Phalkon-Industries/phoenix-instrument/README.md

Git repo for the content of the new Phoenix ph handheld instrument.
