Phalkon-Industries/phoenix-instrument/kicad/phoenix-main-board/PCB Art/V1.0.0-Stormcloud.png

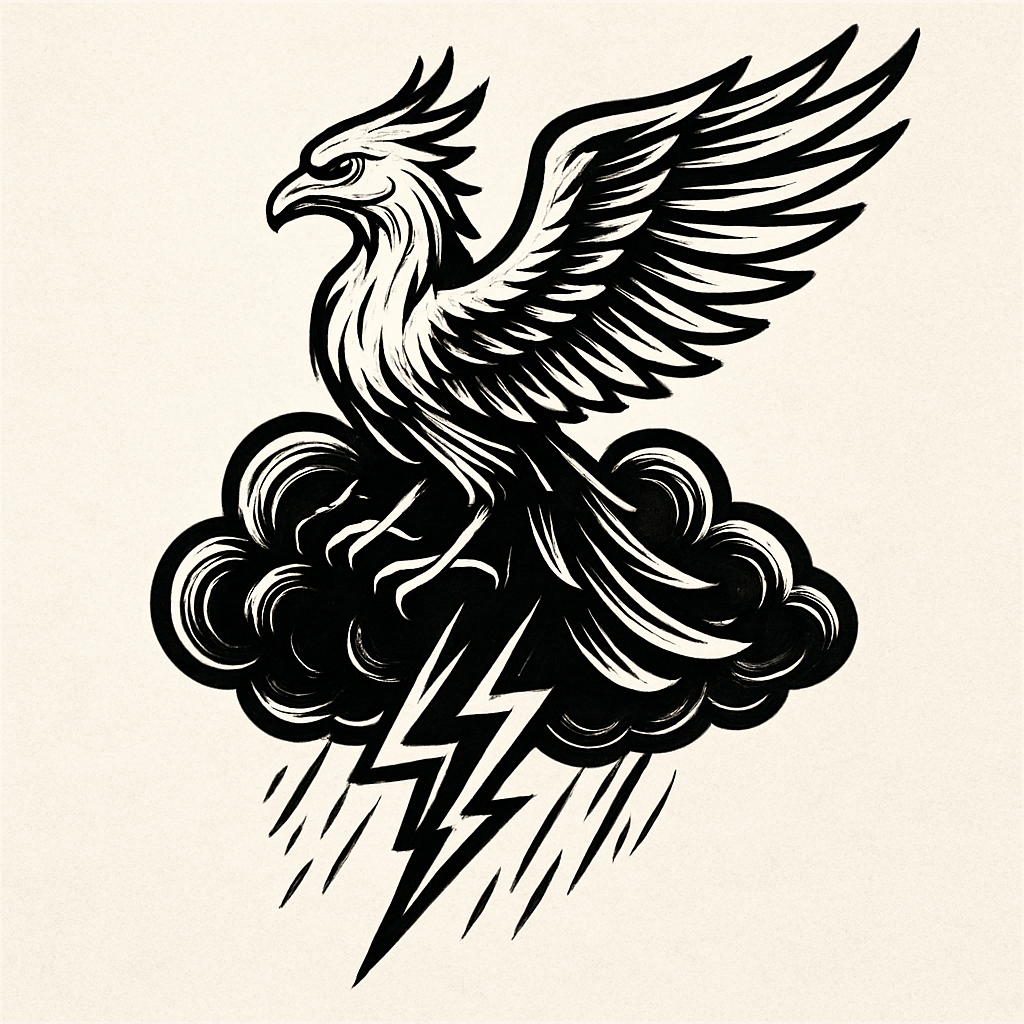
kicad/phoenix-main-board/PCB Art/V1.0.0-Stormcloud.png
