Phalkon-Industries/phoenix-instrument/kicad/phoenix-main-board/PCB Art/V1.0.1-Tsunami.png

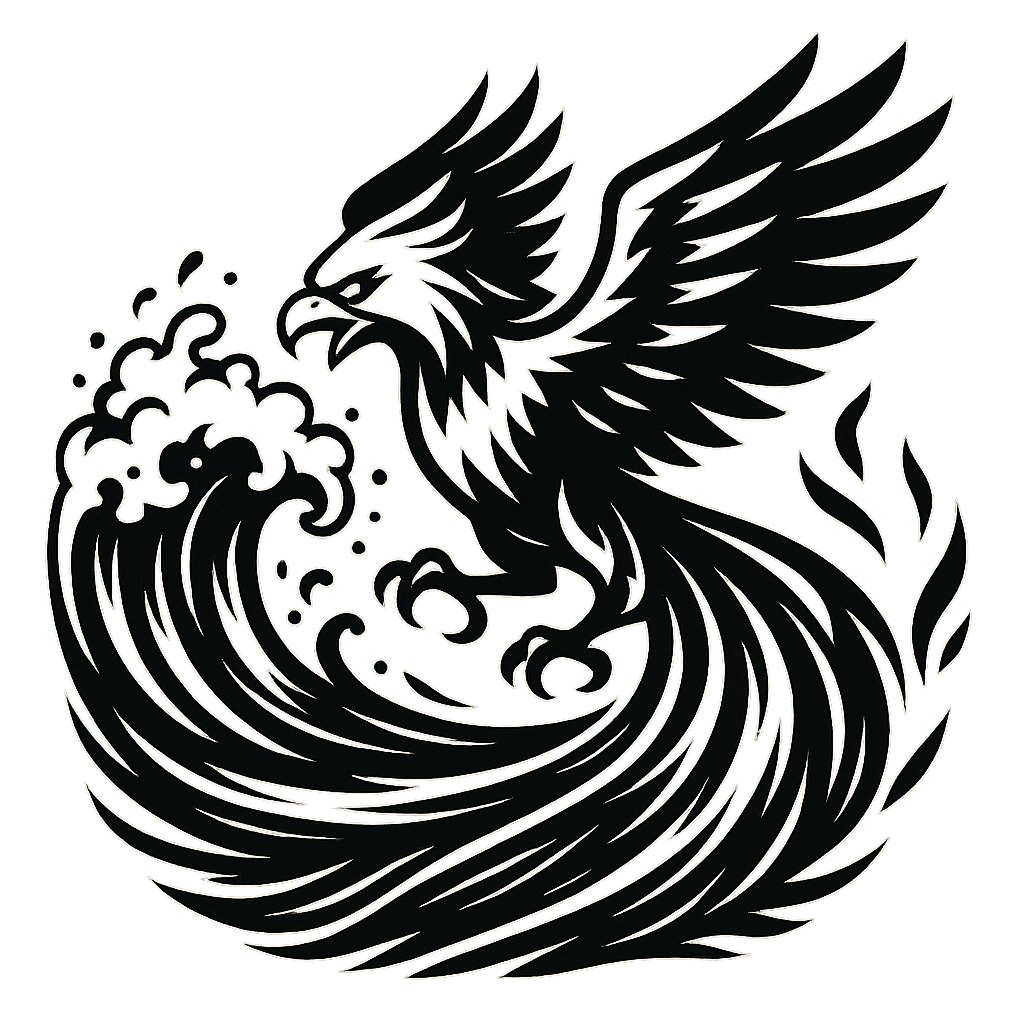
kicad/phoenix-main-board/PCB Art/V1.0.1-Tsunami.png
