Phalkon-Industries/phoenix-instrument/kicad/phoenix-main-board/PCB Art/V1.1.0-Tornado.png

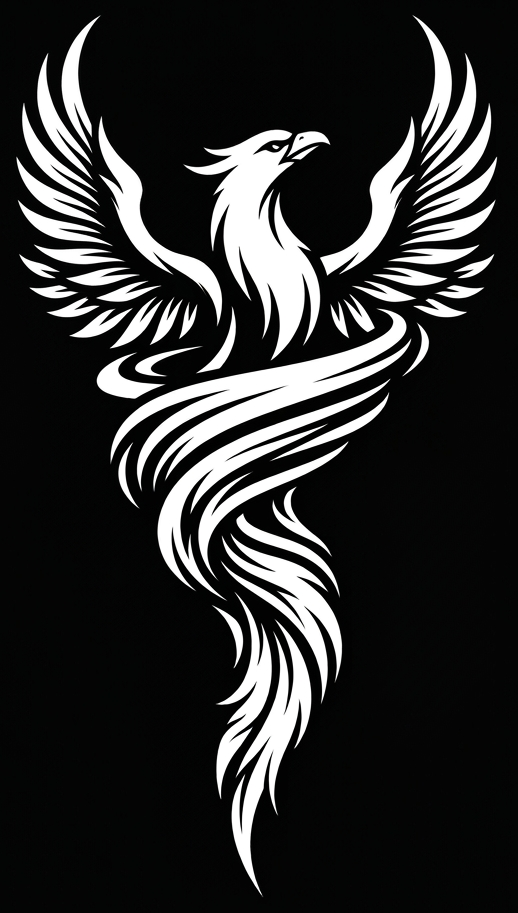
kicad/phoenix-main-board/PCB Art/V1.1.0-Tornado.png
