Phalkon-Industries/phoenix-instrument/kicad/phoenix-main-board/phoenix-main-board-BOM.csv

Id | Designator | Footprint | Quantity | Designation | Supplier and ref
1 | TP25,TP11,TP31,TP7,TP2,TP16,TP23,TP22,TP9,TP33,TP14,TP15,TP5,TP3,TP1,TP26,TP34,TP10,TP4,TP19,TP18,TP32,TP29,TP27,TP17,TP20,TP8,TP24,TP6,TP12,TP28,TP21,TP13 | TestPoint_Keystone_5000-5004_Miniature | 33 | TestPoint_Small
2 | U11 | Texas_RSA_VQFN-16-1EP_4x4mm_P0.65mm_EP2.7x2.7mm | 1 | MCP41U83T
3 | R19,R20 | R_0603_1608Metric | 2 | 100
4 | R7,R8,R10,R11,R12,Rout1,R13,R16,R9 | R_0603_1608Metric | 9 | 10
5 | C12,C18,C7,C13,C16,C15,C21,C1,C17,C4 | C_0603_1608Metric | 10 | 100nF
6 | C5,C2 | C_0603_1608Metric | 2 | 4.7uF
7 | U1 | VSSOP-8_3x3mm_P0.65mm | 1 | LM7705
8 | U7 | MSOP-8_3x3mm_P0.65mm | 1 | OPA2380
9 | C6,C14,C8,C3 | C_0603_1608Metric | 4 | 10uF
10 | FID3,FID2 |  | 2
11 | R2,RFB2,RFB1 | R_0603_1608Metric | 3 | 0
12 | Rset1 | R_0603_1608Metric | 1 | 20k
13 | U2 | DFN-8-1EP_3x3mm_P0.5mm_EP1.66x2.38mm | 1 | LT3092xDD
14 | R5,R4 | R_0603_1608Metric | 2 | 2K
15 | C9 | C_0603_1608Metric | 1 | 22uF
16 | C11,C20,C10,C19 | C_0603_1608Metric | 4 | 1uF
17 | U5 | VSSOP-8_2.3x2mm_P0.5mm | 1 | TS5A3359
18 | R3 | R_0603_1608Metric | 1 | 75
19 | U9 | TSSOP-20_4.4x6.5mm_P0.65mm | 1 | MCP3564
20 | TH1 | R_0603_1608Metric | 1 | DriveStageThermistor
21 | R14,R24,R18,R23,R21,R17,R15,R6 | R_0603_1608Metric | 8 | 10k
22 | U3 | SOT-23-6 | 1 | MCP1640Bx-xCHY
23 | L1 | L_Wuerth_WE-TPC-3816 | 1 | 4.7uH
24 | R26 | R_0603_1608Metric | 1 | 301k
25 | FID1 | Fiducial_1mm_Mask2mm | 1 | Fiducial_1mm_Mask2mm
26 | U12 | SOT-23-5 | 1 | TPS7A2050
27 | TH5 | R_0603_1608Metric | 1 | GainStageThermistor
28 | U8 | TSSOP-16_4.4x5mm_P0.65mm | 1 | AD5242
29 | R1 | R_0603_1608Metric | 1 | 182
30 | U6 | SOT-23-5 | 1 | TPS7A2033
31 | R25 | R_0603_1608Metric | 1 | 1M
32 | FB1 | R_0603_1608Metric | 1 | 120ohm@100MHz
33 | TH4 | ThermistorWire | 1 | BlueLED Thermistor
34 | D2 | LED_D5.0mm_Horizontal_O1.27mm_Z3.0mm | 1 | GreenLED
35 | D1 | LED_D5.0mm_Horizontal_O1.27mm_Z3.0mm | 1 | BlueLED
36 | TH2 | ThermistorWire | 1 | Sample Thermistor
37 | U4 | Adafruit Feather nrf52840 Express | 1 | Adafruit_Feather_nrf52840_Express
38 | PD_Green1,PD_Blue1 | PD_Vertical | 2 | Photodiode
39 | TH3 | ThermistorWire | 1 | GreenLEDThermistor
