Phalkon-Industries/phoenix-instrument/freecad/phoenix-assembly.FCStd

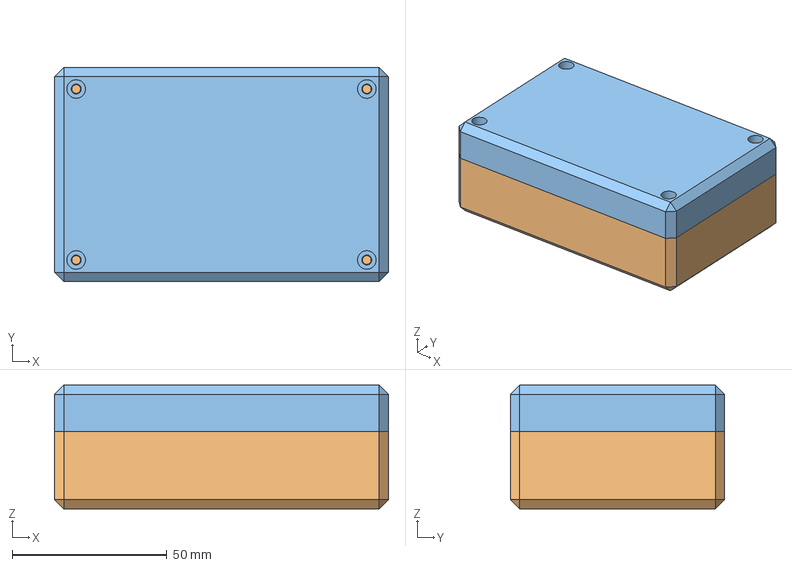
[picture p4: CAD file, 2026-10-06]
freecad/phoenix-assembly.FCStd
107.9 x 69.2 x 40.0 mm
