Phalkon-Industries/phoenix-instrument/freecad/lee-filter-holder-for-cuvette.FCStd

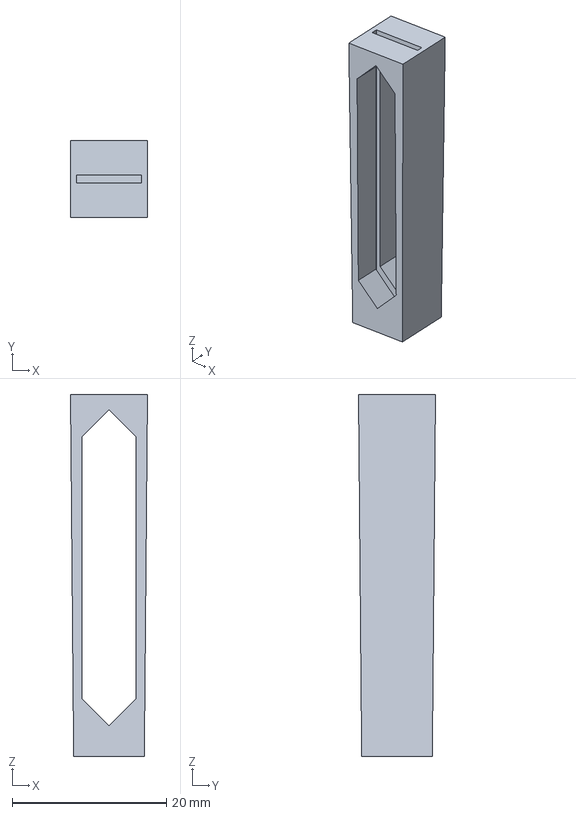
[picture p5: CAD file, 2026-03-20]
freecad/lee-filter-holder-for-cuvette.FCStd
10.0 x 10.0 x 47.0 mm
