Phalkon-Industries/phoenix-instrument/freecad/prusaslicer-enclosure.3mf

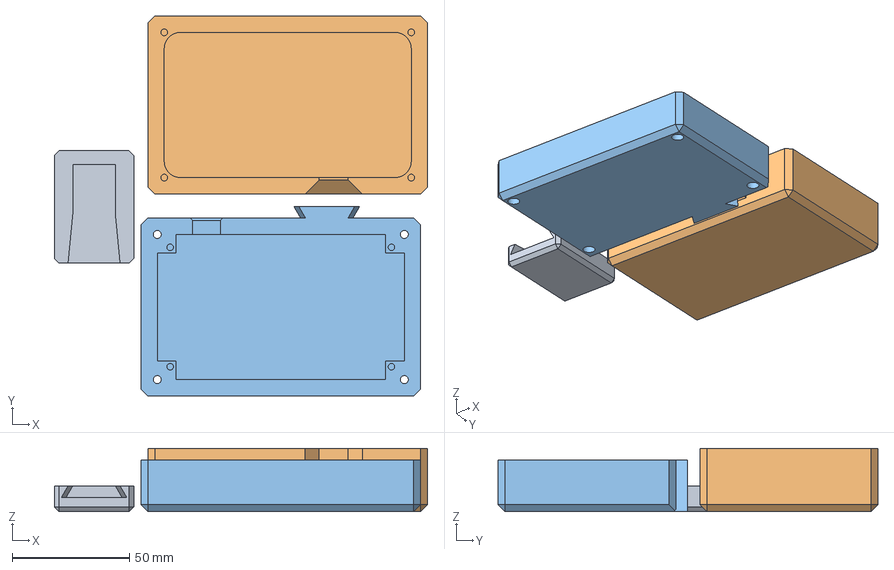
[picture p6: CAD file, 2026-03-20]
freecad/prusaslicer-enclosure.3mf
159.4 x 162.3 x 27.0 mm
ecnlosure-cap
ecnlosure-front
ecnlosure-back
