Phalkon-Industries/phoenix-instrument/freecad/ecnlosure-cap.3mf

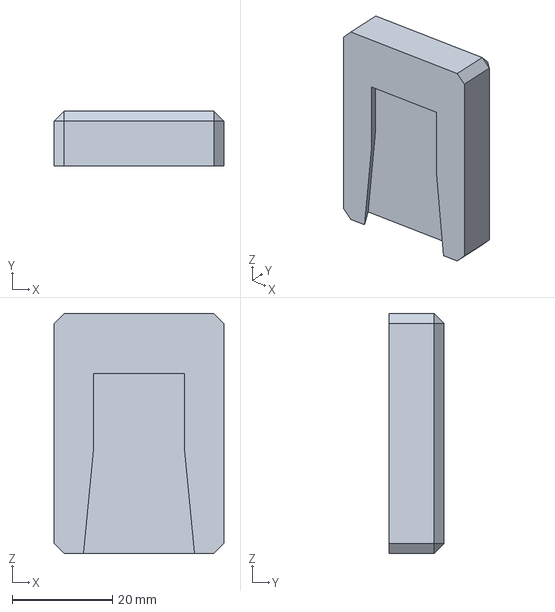
[picture p7: CAD file, 2025-12-11]
freecad/ecnlosure-cap.3mf
33.9 x 11.0 x 48.0 mm
