Phalkon-Industries/phoenix-instrument/freecad/ecnlosure-front.3mf

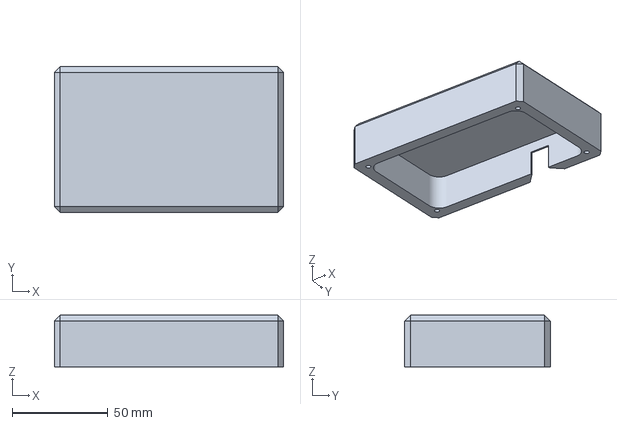
[picture p8: CAD file, 2025-12-11]
freecad/ecnlosure-front.3mf
119.5 x 76.0 x 27.0 mm
