Phalkon-Industries/phoenix-instrument/freecad/ecnlosure-back.3mf

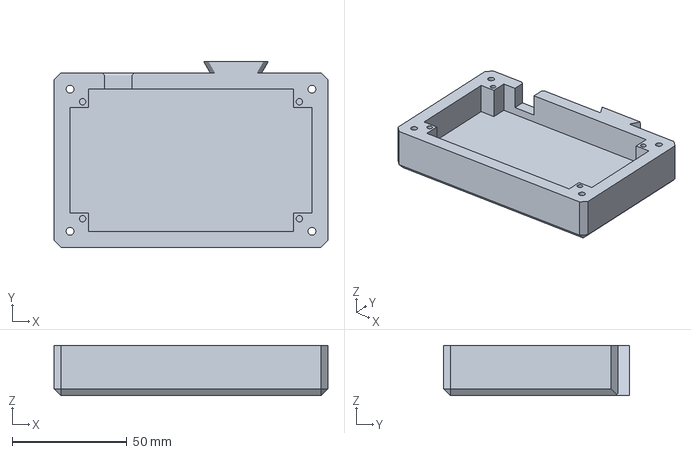
[picture p9: CAD file, 2025-12-11]
freecad/ecnlosure-back.3mf
119.5 x 81.0 x 22.0 mm
