Phalkon-Industries/phoenix-instrument/freecad/shroud-test.3mf

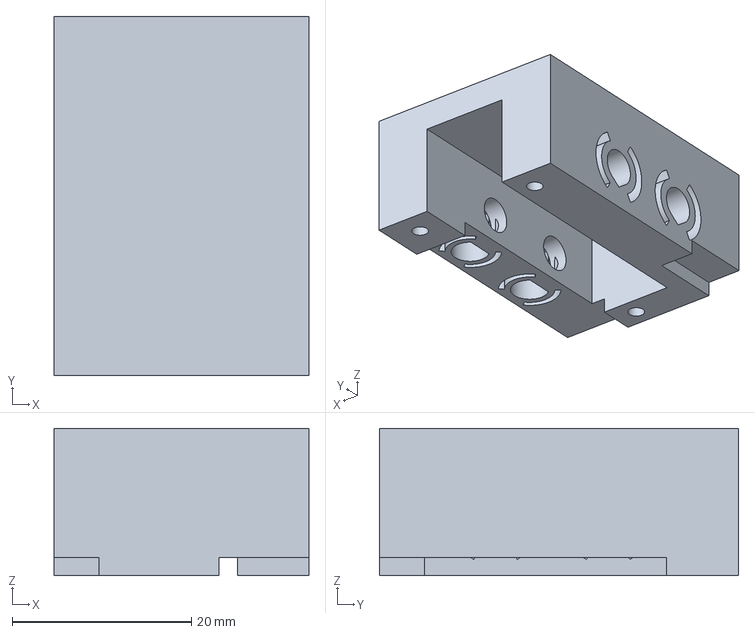
[picture p10: CAD file, 2025-12-05]
freecad/shroud-test.3mf
28.4 x 40.0 x 16.4 mm
