Phalkon-Industries/phoenix-instrument/freecad/Cuvette.FCStd

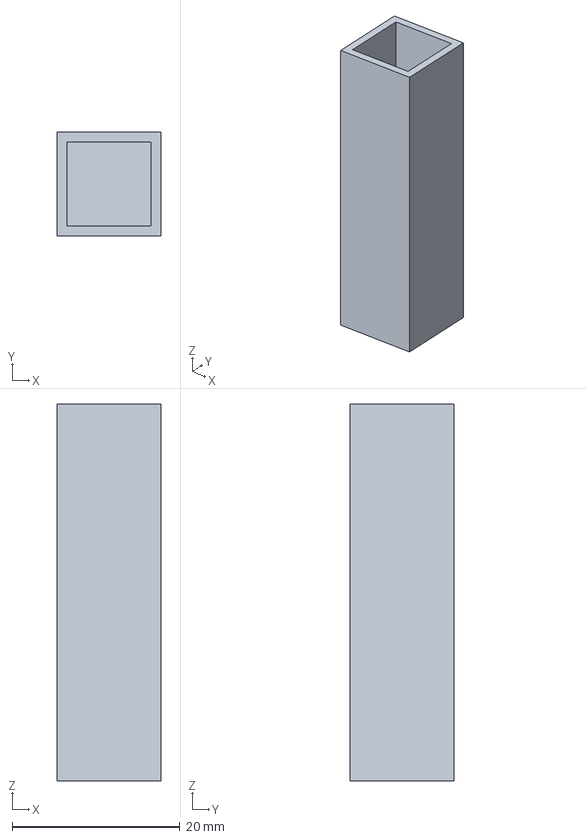
[picture p11: CAD file, 2025-12-05]
freecad/Cuvette.FCStd
12.4 x 12.4 x 45.0 mm
