Phalkon-Industries/phoenix-instrument/freecad/Photodiode.FCStd

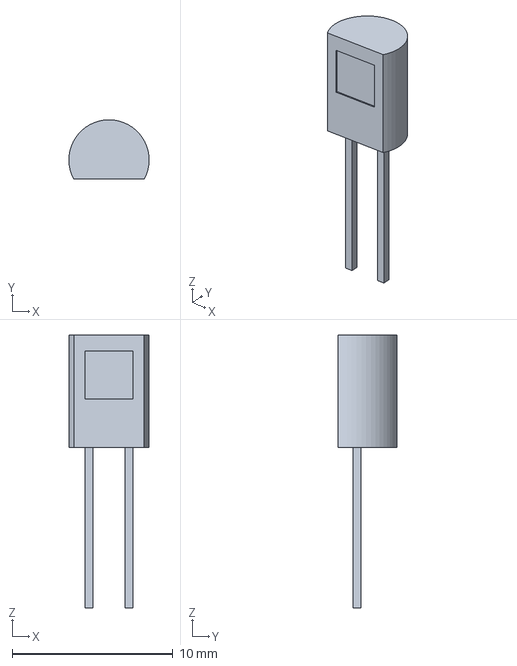
[picture p12: CAD file, 2025-12-05]
freecad/Photodiode.FCStd
5.00 x 3.70 x 17.0 mm
