Phalkon-Industries/phoenix-instrument/freecad/LED.FCStd

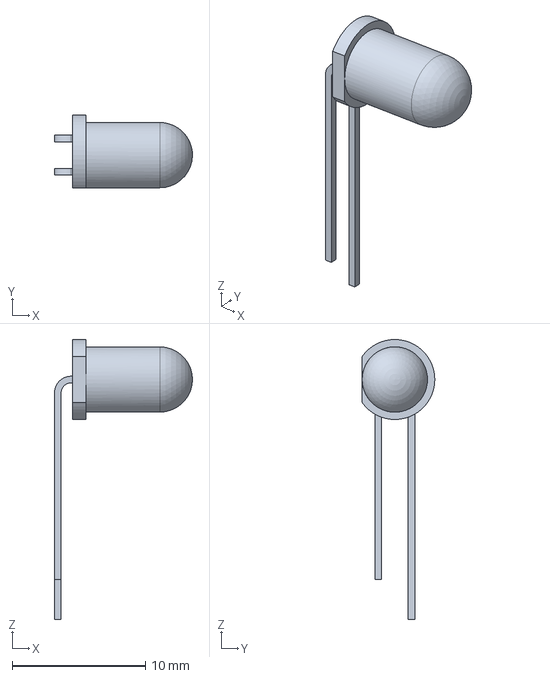
[picture p13: CAD file, 2025-12-05]
freecad/LED.FCStd
10.4 x 5.45 x 21.0 mm
