Phalkon-Industries/phoenix-instrument/freecad/phoenix-pcb-v1.0.1-tsunami.FCStd

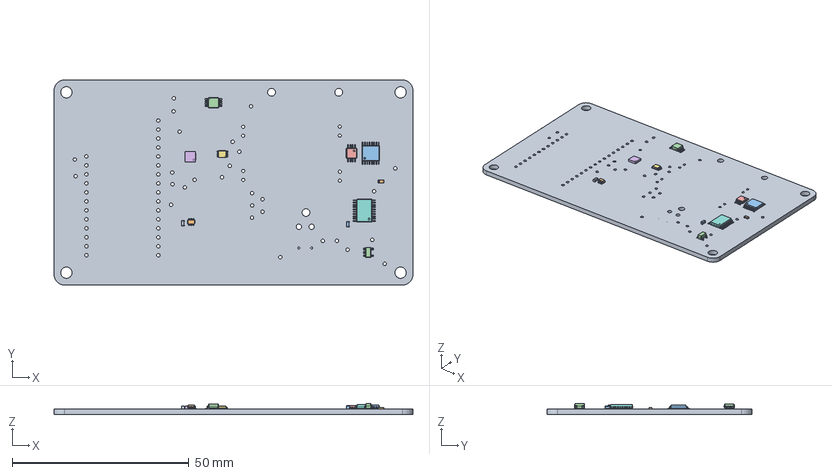
[picture p14: CAD file, 2025-12-05]
freecad/phoenix-pcb-v1.0.1-tsunami.FCStd
101.5 x 58.0 x 3.15 mm
Pcb_bfa0
R19_R_0603_1608Metric_e81c35781ce5
C12_C_0603_1608Metric_43dd25189e75
U1_VSSOP-8_3x3mm_P0.65mm_b0bd8732d9d8
U7_MSOP_8_3x3mm_P065mm_0b8d5e192aae
U2_DFN-8-1EP_3x3mm_Pitch0.5mm_9c5140f70b24
U5_VSSOP_8_23x2mm_P05mm_af9a6c2f9d9d
U9_TSSOP_20_44x65mm_P065mm_1748040f196b
L1_L_0603_1608Metric_6e4b57586c89
U3_SOT_363_SC_70_6_2b77724525eb
U8_TSSOP_16_44x5mm_P065mm_5ce80917f075
U6_SOT_23_5_cae0d91c1014
