Phalkon-Industries/phoenix-instrument/(list of files, cad)

Other CAD files:
freecad/lee-filter-holder-for-cuvette-BodyPocket002.step
