Phalkon-Industries/phoenix-instrument/kicad/phoenix-main-board/phoenix-main-board.kicad_pcb

## KiCad design kicad/phoenix-main-board/phoenix-main-board.kicad_pcb (2026-10-06)

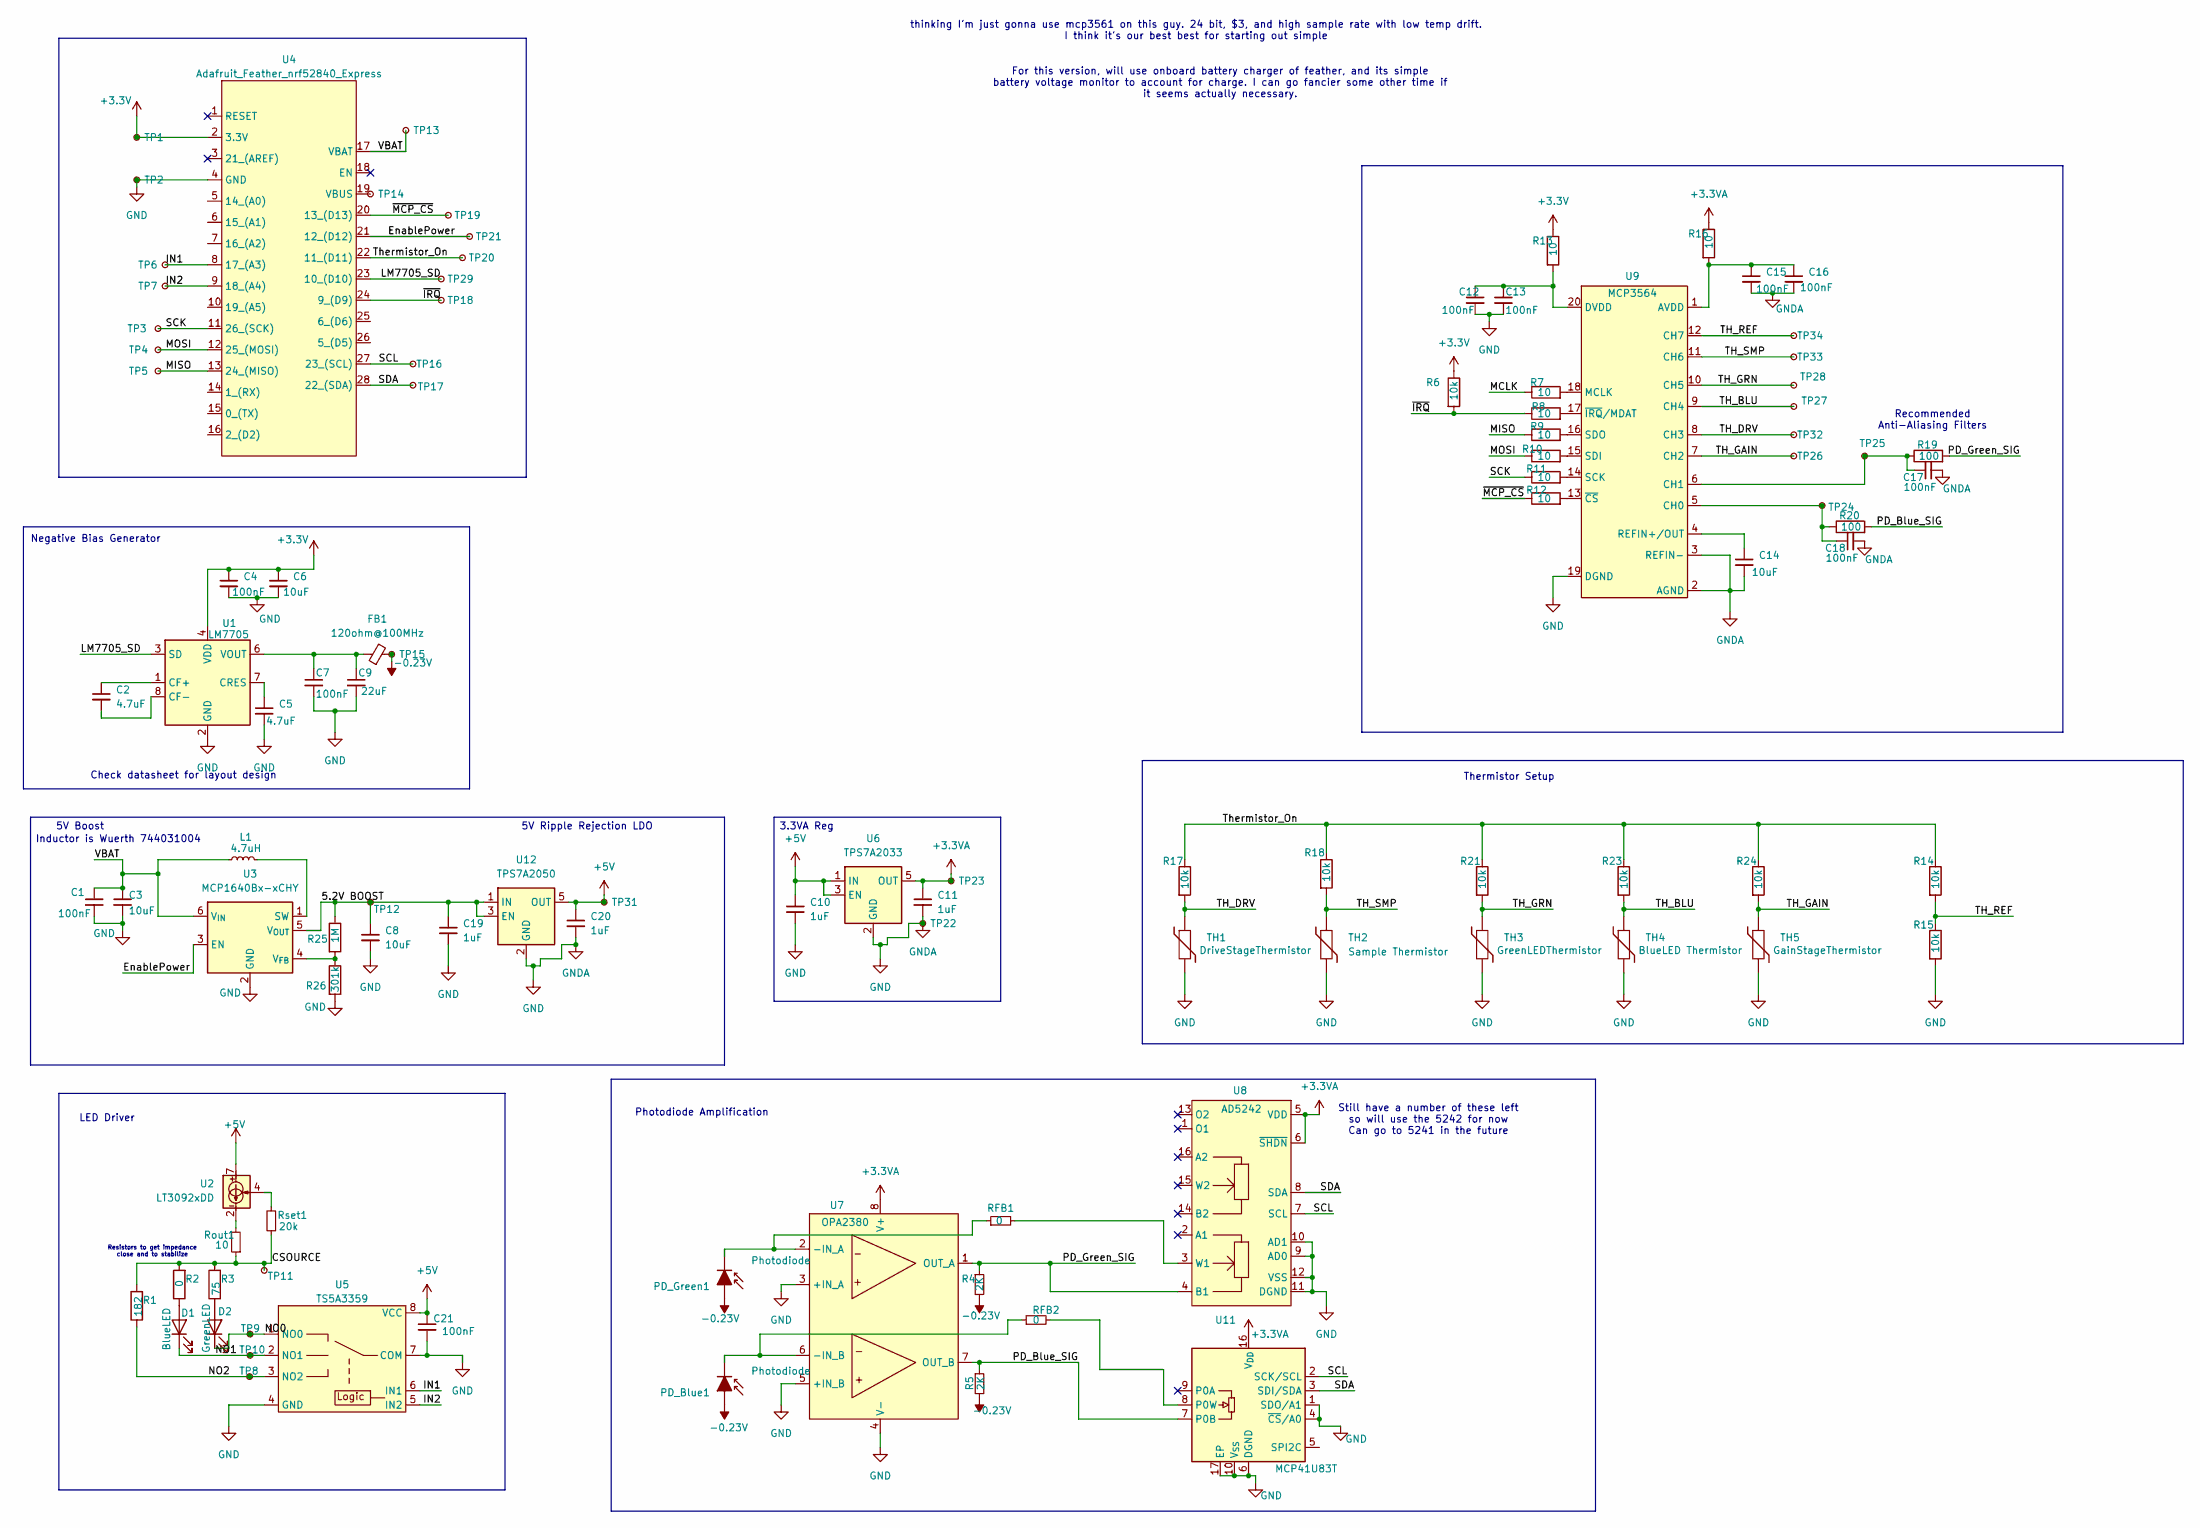
[picture p15: schematic phoenix-main-board.kicad_sch]

Parts:
C1, C4, C7, C12, C13, C15, C16, C17, C18, C21: 100nF; C_0603_1608Metric
C2, C5: 4.7uF; C_0603_1608Metric
C3, C6, C8, C14: 10uF; C_0603_1608Metric
C9: 22uF; C_0603_1608Metric
C10, C11, C19, C20: 1uF; C_0603_1608Metric
D1: BlueLED; LED_D5.0mm_Horizontal_O1.27mm_Z3.0mm
D2: GreenLED; LED_D5.0mm_Horizontal_O1.27mm_Z3.0mm
FB1: 120ohm@100MHz; R_0603_1608Metric
L1: 4.7uH; L_Wuerth_WE-TPC-3816
PD_Blue1: Photodiode; PD_Vertical
PD_Green1: Photodiode; PD_Vertical
R1: 182; R_0603_1608Metric
R2: 0; R_0603_1608Metric
R3: 75; R_0603_1608Metric
R4, R5: 2K; R_0603_1608Metric
R6, R14, R15, R17, R18, R21, R23, R24: 10k; R_0603_1608Metric
R7, R8, R9, R10, R11, R12, R13, R16: 10; R_0603_1608Metric
R19, R20: 100; R_0603_1608Metric
R25: 1M; R_0603_1608Metric
R26: 301k; R_0603_1608Metric
RFB1, RFB2: 0; R_0603_1608Metric
Rout1: 10; R_0603_1608Metric
Rset1: 20k; R_0603_1608Metric
TH1: DriveStageThermistor; R_0603_1608Metric
TH2: Sample Thermistor; ThermistorWire
TH3: GreenLEDThermistor; ThermistorWire
TH4: BlueLED Thermistor; ThermistorWire
TH5: GainStageThermistor; R_0603_1608Metric
TP1, TP2, TP3, TP4, TP5, TP6, TP7, TP8, TP9, TP10, TP11, TP12, TP13, TP14, TP15, TP16, TP17, TP18, TP19, TP20, TP21, TP22, TP23, TP24, TP25, TP26, TP27, TP28, TP29, TP31, TP32, TP33, TP34: TestPoint_Small; TestPoint_Keystone_5000-5004_Miniature
U1: LM7705; VSSOP-8_3x3mm_P0.65mm
U2: LT3092xDD; DFN-8-1EP_3x3mm_P0.5mm_EP1.66x2.38mm
U3: MCP1640Bx-xCHY; SOT-23-6
U4: Adafruit_Feather_nrf52840_Express; Adafruit Feather nrf52840 Express
U5: TS5A3359; VSSOP-8_2.3x2mm_P0.5mm
U6: TPS7A2033; SOT-23-5
U7: OPA2380; MSOP-8_3x3mm_P0.65mm
U8: AD5242; TSSOP-16_4.4x5mm_P0.65mm
U9: MCP3564; TSSOP-20_4.4x6.5mm_P0.65mm
U11: MCP41U83T; Texas_RSA_VQFN-16-1EP_4x4mm_P0.65mm_EP2.7x2.7mm
U12: TPS7A2050; SOT-23-5

Connections:
+3.3V: C4.1, C6.1, R6.1, R13.1, TP1.1, U1.4 (VDD), U4.2 (3.3V)
+3.3VA: C11.1, R16.1, TP23.1, U6.5 (OUT), U7.8 (V+), U8.5 (VDD), U8.6 (~SHDN), U11.16 (V_{DD})
+5V: C10.1, C20.1, C21.1, TP31.1, U2.7, U2.8, U5.8 (VCC), U6.1 (IN), U6.3 (EN), U12.5 (OUT)
-0.23V: FB1.2, PD_Blue1.2 (A), PD_Green1.2 (A), R4.2, R5.2, TP15.1
/5.2V BOOST: C8.1, C19.1, R25.1, TP12.1, U3.5 (V_{OUT}), U12.1 (IN), U12.3 (EN)
/CSOURCE: R1.2, R2.2, R3.2, Rout1.1, Rset1.1, TP11.1
/EnablePower: TP21.1, U3.3 (EN), U4.21 (12_(D12))
/IN1: TP6.1, U4.8 (17_(A3)), U5.6 (IN1)
/IN2: TP7.1, U4.9 (18_(A4)), U5.5 (IN2)
/LM7705_SD: TP29.1, U1.3 (SD), U4.23 (10_(D10))
/MCLK: R7.1
/MISO: R9.1, TP5.1, U4.13 (24_(MISO))
/MOSI: R10.1, TP4.1, U4.12 (25_(MOSI))
/NO0: D2.1 (K), TP9.1, U5.1 (NO0)
/NO1: D1.1 (K), TP10.1, U5.2 (NO1)
/NO2: R1.1, TP8.1, U5.3 (NO2)
/PD_Blue_SIG: R5.1, R20.2, U7.7 (OUT_B), U11.7 (P0B)
/PD_Green_SIG: R4.1, R19.2, U7.1 (OUT_A), U8.4 (B1)
/SCK: R11.1, TP3.1, U4.11 (26_(SCK))
/SCL: TP16.1, U4.27 (23_(SCL)), U8.7 (SCL), U11.2 (SCK/SCL)
/SDA: TP17.1, U4.28 (22_(SDA)), U8.8 (SDA), U11.3 (SDI/SDA)
/TH_BLU: R23.2, TH4.1, TP27.1, U9.9 (CH4)
/TH_DRV: R17.2, TH1.1, TP32.1, U9.8 (CH3)
/TH_GAIN: R24.2, TH5.1, TP26.1, U9.7 (CH2)
/TH_GRN: R21.2, TH3.1, TP28.1, U9.10 (CH5)
/TH_REF: R14.2, R15.1, TP34.1, U9.12 (CH7)
/TH_SMP: R18.2, TH2.1, TP33.1, U9.11 (CH6)
/Thermistor_On: R14.1, R17.1, R18.1, R21.1, R23.1, R24.1, TP20.1, U4.22 (11_(D11))
/VBAT: C1.1, C3.1, L1.1, TP13.1, U3.6 (V_{IN}), U4.17 (VBAT)
/~IRQ: R6.2, R8.1, TP18.1, U4.24 (9_(D9))
/~MCP_CS: R12.1, TP19.1, U4.20 (13_(D13))
GND: C1.2, C3.2, C4.2, C5.2, C6.2, C7.2, C8.2, C9.2, C10.2, C11.2, C12.2, C13.2, C14.2, C15.2, C16.2, C17.2, C18.2, C19.2, C20.2, C21.2, R15.2, R26.2, TH1.2, TH2.2, TH3.2, TH4.2, TH5.2, TP2.1, TP22.1, U1.2 (GND), U1.5 (GND), U3.2 (GND), U4.4 (GND), U5.4 (GND), U5.7 (COM), U6.2 (GND), U7.3 (+IN_A), U7.4 (V-), U7.5 (+IN_B), U8.9 (AD0), U8.10 (AD1), U8.11 (DGND), U8.12 (VSS), U9.2 (AGND), U9.3 (REFIN-), U9.19 (DGND), U11.1 (SDO/A1), U11.4 (~CS/A0), U11.6 (DGND), U11.10 (V_{SS}), U11.17 (EP), U12.2 (GND)
unnamed: D1.2 (A), R2.1
unnamed: D2.2 (A), R3.1
unnamed: PD_Blue1.1 (K), RFB2.1, U7.6 (-IN_B)
unnamed: PD_Green1.1 (K), RFB1.1, U7.2 (-IN_A)
unnamed: Rout1.2, U2.1, U2.2, U2.9
unnamed: Rset1.2, U2.4
unnamed: C2.1, U1.1 (CF+)
unnamed: C2.2, U1.8 (CF-)
unnamed: C5.1, U1.7 (CRES)
unnamed: C7.1, C9.1, FB1.1, U1.6 (VOUT)
unnamed: L1.2, U3.1 (SW)
unnamed: R25.2, R26.1, U3.4 (V_{FB})
unnamed: TP14.1, U4.19 (VBUS)
unnamed: RFB1.2, U8.3 (W1)
unnamed: C15.1, C16.1, R16.2, U9.1 (AVDD)
unnamed: C18.1, R20.1, TP24.1, U9.5 (CH0)
unnamed: C17.1, R19.1, TP25.1, U9.6 (CH1)
unnamed: C12.1, C13.1, R13.2, U9.20 (DVDD)
unnamed: R7.2, U9.18 (MCLK)
unnamed: C14.1, U9.4 (REFIN+/OUT)
unnamed: R11.2, U9.14 (SCK)
unnamed: R10.2, U9.15 (SDI)
unnamed: R9.2, U9.16 (SDO)
unnamed: R12.2, U9.13 (~CS)
unnamed: R8.2, U9.17 (~IRQ/MDAT)
unnamed: RFB2.2, U11.8 (P0W)

Notes on the sheet:
Inductor is Wuerth 744031004
For this version, will use onboard battery charger of feather, and its simple battery voltage monitor to account for charge. I can go fancier some other time if it seems actually necessary.
Check datasheet for layout design
Photodiode Amplification
3.3VA Reg
Resistors to get impedance close and to stabilize
Recommended Anti-Aliasing Filters
thinking I'm just gonna use mcp3561 on this guy. 24 bit, $3, and high sample rate with low temp drift. I think it's our best best for starting out simple
LED Driver
5V Boost
Negative Bias Generator
Thermistor Setup
5V Ripple Rejection LDO
Still have a number of these left so will use the 5242 for now Can go to 5241 in the future

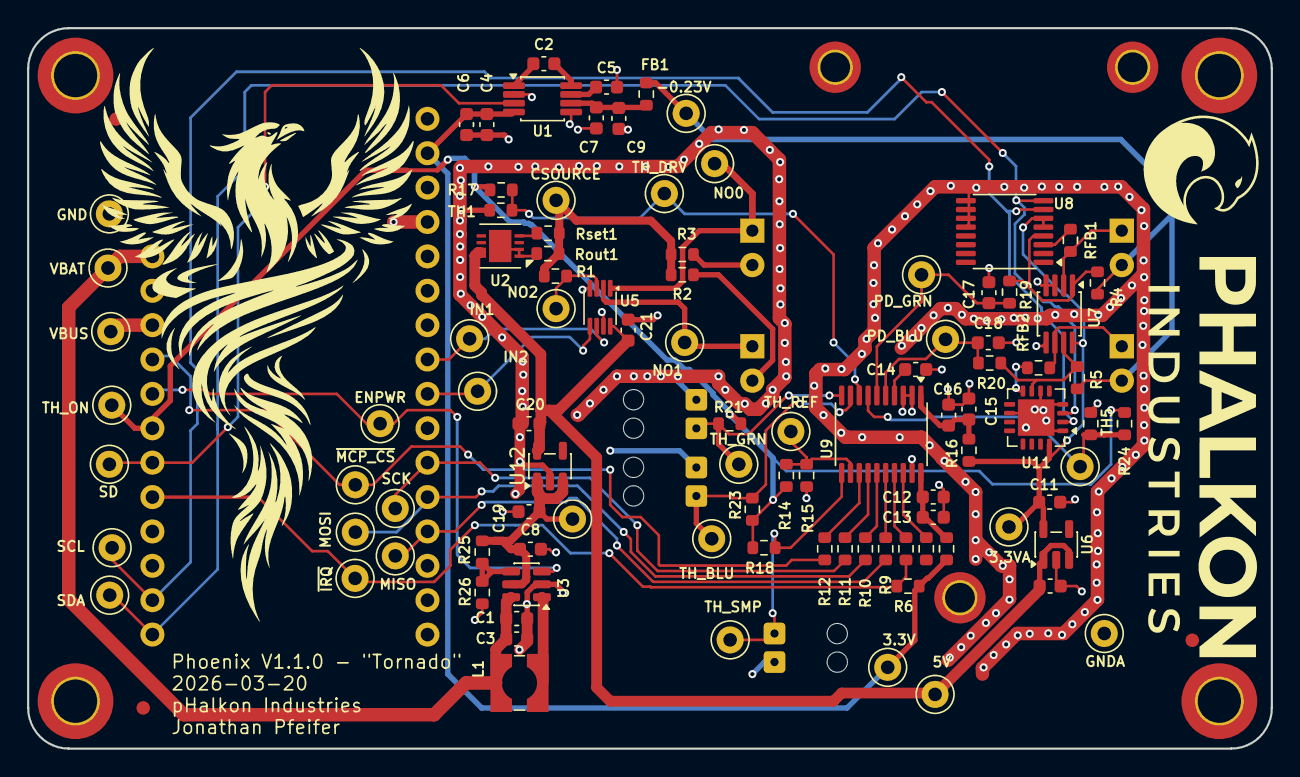
[picture p16: board phoenix-main-board.kicad_pcb from above]

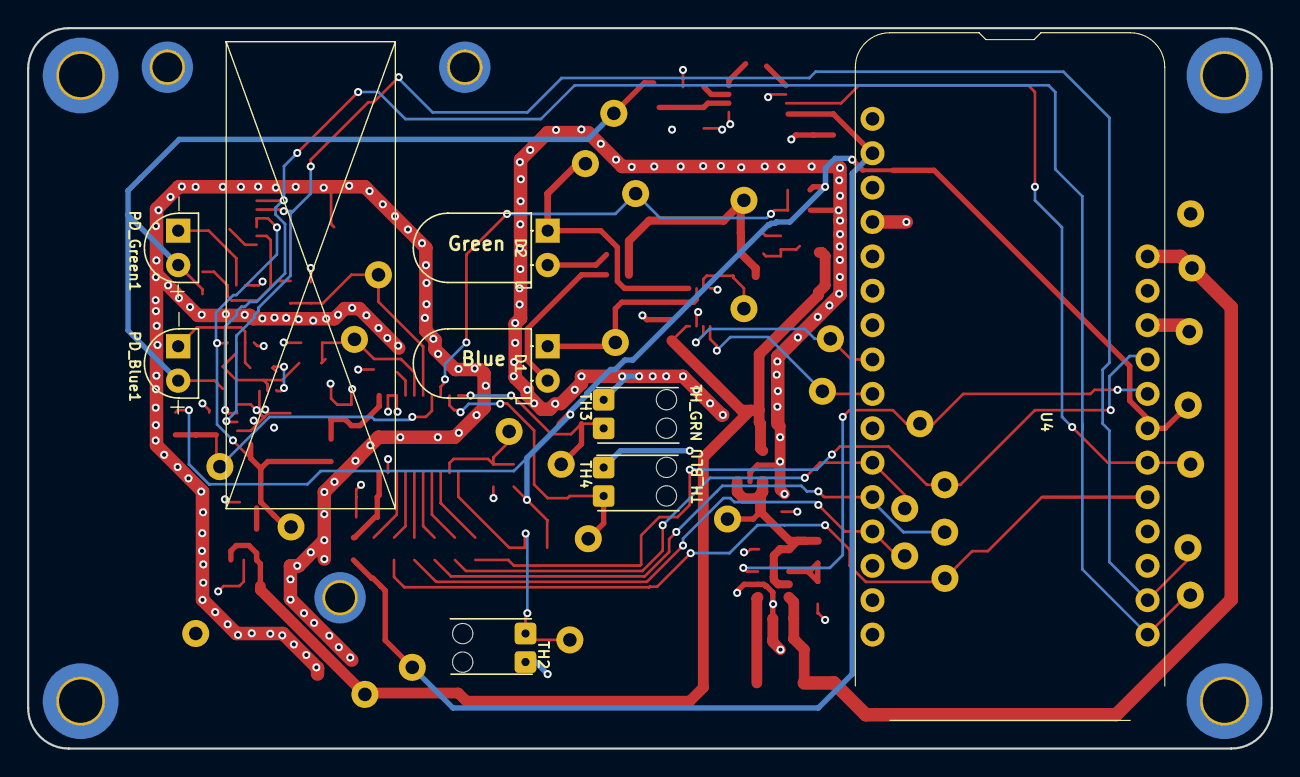
[picture p17: board phoenix-main-board.kicad_pcb from below]

Board: 4 copper layers, 91.9 x 53.2 mm, 108 parts (8 on the bottom side), 57 nets.

Other parts of the board:
FID1: Fiducial_1mm_Mask2mm
FID2, FID3: (no value)
