Phalkon-Industries/phoenix-instrument/kicad/feather-schematics/Adafruit nRF52840 Bluefruit Feather Express Rev E.kicad_pcb

## KiCad design kicad/feather-schematics/Adafruit nRF52840 Bluefruit Feather Express Rev E.kicad_pcb (2025-07-11)

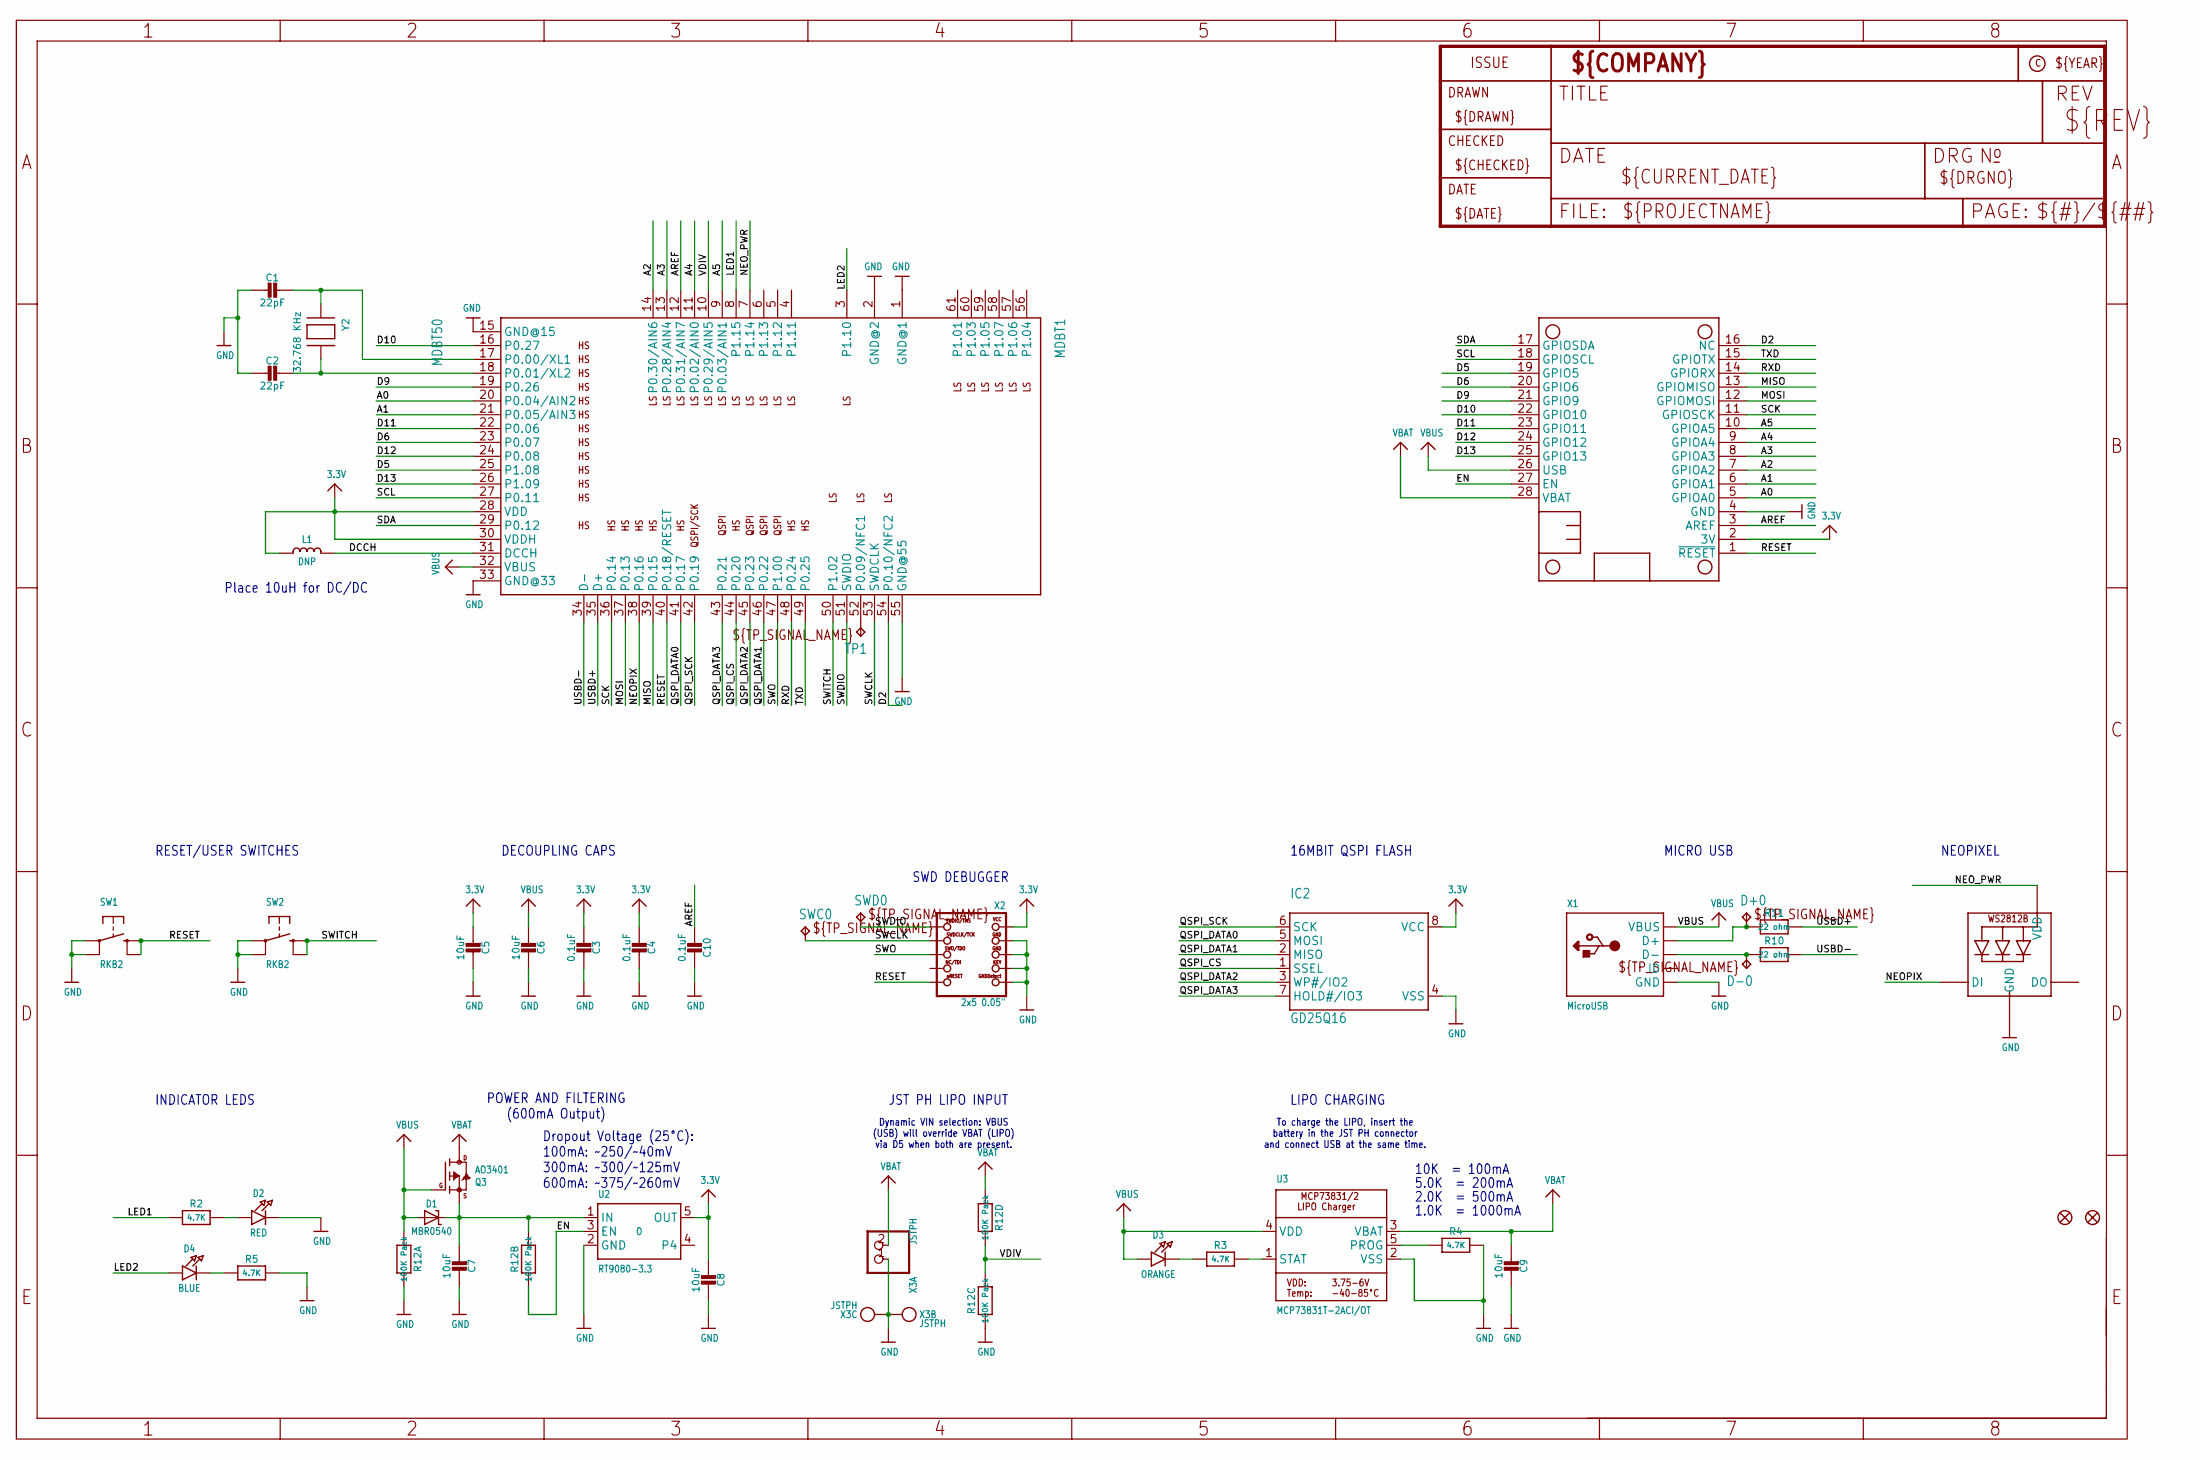
[picture p18: schematic Adafruit nRF52840 Bluefruit Feather Express Rev E.kicad_sch]

Parts:
C1, C2: 22pF; 0603-NO
C3, C4, C10: 0.1uF; 0603-NO
C5, C6, C7, C8, C9: 10uF; 0805-NO
D1: MBR0540; SOD-123
D2: RED; CHIPLED_0603_NOOUTLINE
D3: ORANGE; CHIPLED_0603_NOOUTLINE
D4: BLUE; CHIPLED_0603_NOOUTLINE
D+0: TPTP10R; TP10R
D-0: TPTP10R; TP10R
FID1, FID2: FIDUCIAL_1MM
IC2: GD25Q16; USON8
L1: DNP; _0805MP
LED1: WS2812B_3535FULL; LED3535_FULLPADS
MDBT1: MDBT50
MS1: FEATHERWING_NODIM
Q3: AO3401; SOT23-R
R2, R3, R4, R5: 4.7K; 0603-NO
R10, R11: 22 ohm; _0603MP
R12: 100K Pack; RESPACK_4X0603
SW1, SW2: RKB2; BTN_RKB2_4.6X2.8
SWC0: TPTP12R; TP12R
SWD0: TPTP12R; TP12R
TP1: TPTP10R; TP10R
U2: RT9080-3.3; SOT23-5; JLC_ROTATION 0
U3: MCP73831T-2ACI/OT; SOT23-5
X1: MicroUSB; 4UCONN_20329_V2
X2: 2x5 0.05"; 2X05_1.27MM_BOX_POSTS
X3: JSTPH; JSTPH2_BATT
Y2: 32.768 KHz; XTAL3215

Connections:
3.3V: C3.2, C4.2, C5.2, C8.2, IC2.8 (VCC), L1.1, MDBT1.28 (VDD), MDBT1.30 (VDDH), MS1.2 (3V), U2.5 (OUT), X2.1 (VCC)
A0: MDBT1.20 (P0.04/AIN2), MS1.5 (GPIOA0)
A1: MDBT1.21 (P0.05/AIN3), MS1.6 (GPIOA1)
A2: MDBT1.14 (P0.30/AIN6), MS1.7 (GPIOA2)
A3: MDBT1.13 (P0.28/AIN4), MS1.8 (GPIOA3)
A4: MDBT1.11 (P0.02/AIN0), MS1.9 (GPIOA4)
A5: MDBT1.9 (P0.03/AIN1), MS1.10 (GPIOA5)
AREF: C10.2, MDBT1.12 (P0.31/AIN7), MS1.3 (AREF)
D2: MDBT1.54 (P0.10/NFC2), MS1.16 (NC)
D5: MDBT1.25 (P1.08), MS1.19 (GPIO5)
D6: MDBT1.23 (P0.07), MS1.20 (GPIO6)
D9: MDBT1.19 (P0.26), MS1.21 (GPIO9)
D10: MDBT1.16 (P0.27), MS1.22 (GPIO10)
D11: MDBT1.22 (P0.06), MS1.23 (GPIO11)
D12: MDBT1.24 (P0.08), MS1.24 (GPIO12)
D13: MDBT1.26 (P1.09), MS1.25 (GPIO13)
D+: D+0.TP, R11.1, X1.D+
D-: D-0.TP, R10.1, X1.D-
DCCH: L1.2, MDBT1.31 (DCCH)
EN: MS1.27 (EN), R12.2 (1), U2.3 (EN)
GND: C1.2, C2.2, C3.1, C4.1, C5.1, C6.1, C7.1, C8.1, C9.1, C10.1, D2.C, IC2.4 (VSS), LED1.4 (GND), MDBT1.1 (GND@1), MDBT1.2 (GND@2), MDBT1.15 (GND@15), MDBT1.33 (GND@33), MDBT1.55 (GND@55), MS1.4 (GND), R4.2, R5.2, R12.3 (1), R12.8 (2), SW1.A, SW1.A' (P1), SW2.A, SW2.A' (P1), U2.2 (GND), U3.2 (VSS), X1.BASE@1 (GND), X1.BASE@2 (GND), X1.GND, X1.SPRT@1 (GND), X1.SPRT@2 (GND), X1.SPRT@3 (GND), X1.SPRT@4 (GND), X2.3 (GND@1), X2.5 (GND@2), X2.7 (KEY), X2.9 (GNDDETECT), X3.1, X3.NC1, X3.NC2
LED1: MDBT1.8 (P1.15), R2.1
LED2: D4.A, MDBT1.3 (P1.10)
MISO: MDBT1.39 (P0.15), MS1.13 (GPIOMISO)
MOSI: MDBT1.37 (P0.13), MS1.12 (GPIOMOSI)
unnamed: D3.C, R3.1
unnamed: D2.A, R2.2
unnamed: C1.1, MDBT1.17 (P0.00/XL1), Y2.P$1
unnamed: C2.1, MDBT1.18 (P0.01/XL2), Y2.P$2
unnamed: R3.2, U3.1 (STAT)
unnamed: R4.1, U3.5 (PROG)
unnamed: D4.C, R5.1
NEOPIX: LED1.1 (DI), MDBT1.38 (P0.16)
NEO_PWR: LED1.2 (VDD), MDBT1.7 (P1.14)
NFC2: MDBT1.52 (P0.09/NFC1), TP1.TP
QSPI_CS: IC2.1 (SSEL), MDBT1.44 (P0.20)
QSPI_DATA0: IC2.5 (MOSI), MDBT1.41 (P0.17)
QSPI_DATA1: IC2.2 (MISO), MDBT1.46 (P0.22)
QSPI_DATA2: IC2.3 (WP#/IO2), MDBT1.45 (P0.23)
QSPI_DATA3: IC2.7 (HOLD#/IO3), MDBT1.43 (P0.21)
QSPI_SCK: IC2.6 (SCK), MDBT1.42 (P0.19)
RESET: MDBT1.40 (P0.18/RESET), MS1.1 (~RESET), SW1.B (S), SW1.B' (S1), X2.10 (NRESET)
RXD: MDBT1.48 (P0.24), MS1.14 (GPIORX)
SCK: MDBT1.36 (P0.14), MS1.11 (GPIOSCK)
SCL: MDBT1.27 (P0.11), MS1.18 (GPIOSCL)
SDA: MDBT1.29 (P0.12), MS1.17 (GPIOSDA)
SWCLK: MDBT1.53 (SWDCLK), SWC0.TP, X2.4 (SWDCLK)
SWDIO: MDBT1.51 (SWDIO), SWD0.TP, X2.2 (SWDIO)
SWITCH: MDBT1.50 (P1.02), SW2.B (S), SW2.B' (S1)
SWO: MDBT1.47 (P1.00), X2.6 (SWO)
TXD: MDBT1.49 (P0.25), MS1.15 (GPIOTX)
USBD+: MDBT1.35 (D+), R11.2
USBD-: MDBT1.34 (D-), R10.2
VBAT: C9.2, MS1.28 (VBAT), Q3.3 (D), R12.4 (1), U3.3 (VBAT), X3.2
VBUS: C6.2, D1.A, D3.A, MDBT1.32 (VBUS), MS1.26 (USB), Q3.1 (G), R12.1, U3.4 (VDD), X1.VBUS
VDIV: MDBT1.10 (P0.29/AIN5), R12.5 (2), R12.6 (2)
VHI: C7.2, D1.C, Q3.2 (S), R12.7 (2), U2.1 (IN)

Notes on the sheet:
To charge the LIPO, insert the battery in the JST PH connector and connect USB at the same time.
16MBIT QSPI FLASH
Dynamic VIN selection: VBUS (USB) will override VBAT (LIPO) via D5 when both are present.
Dropout Voltage (25°C): 100mA: ~250/~40mV 300mA: ~300/~125mV 600mA: ~375/~260mV
1.0K = 1000mA
MICRO USB
DECOUPLING CAPS
RESET/USER SWITCHES
INDICATOR LEDS
JST PH LIPO INPUT
POWER AND FILTERING (600mA Output)
SWD DEBUGGER
2.0K = 500mA
NEOPIXEL
Place 10uH for DC/DC
10K = 100mA
LIPO CHARGING
5.0K = 200mA

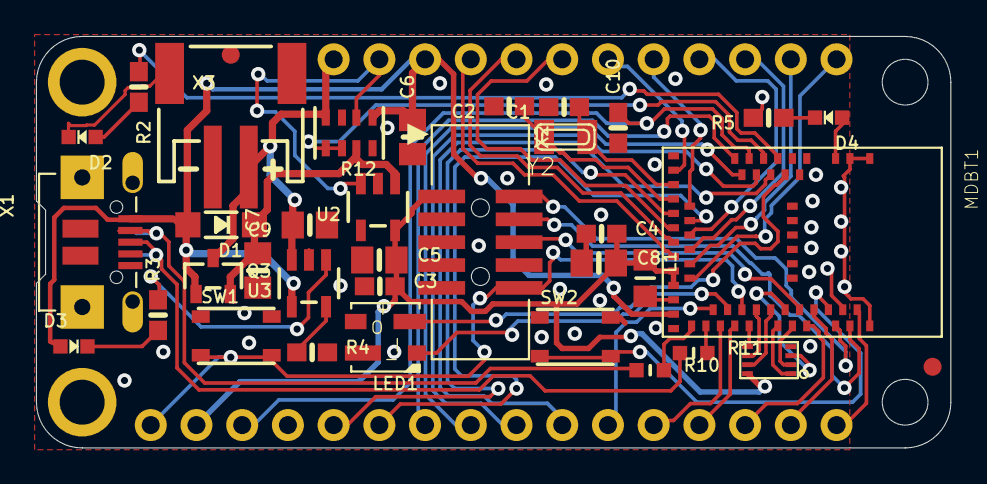
[picture p19: board Adafruit nRF52840 Bluefruit Feather Express Rev E.kicad_pcb from above]

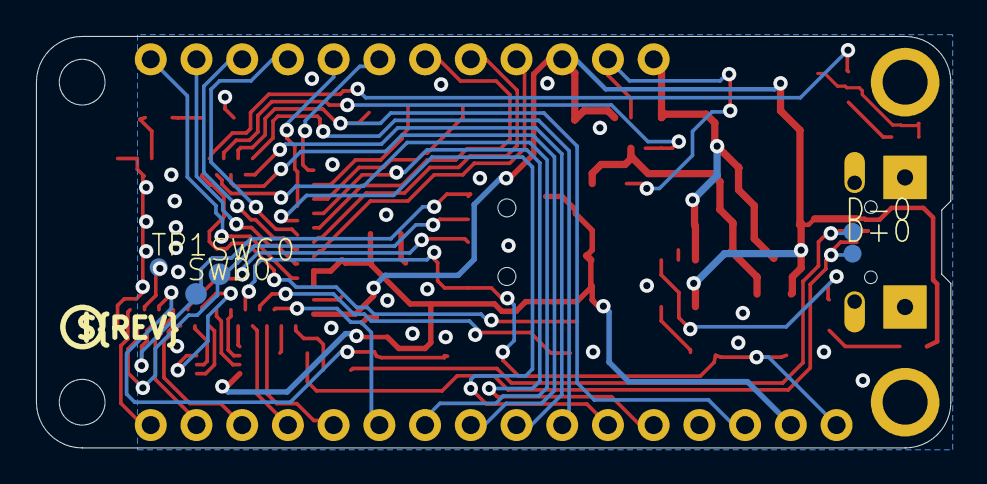
[picture p20: board Adafruit nRF52840 Bluefruit Feather Express Rev E.kicad_pcb from below]

Board: 2 copper layers, 50.8 x 22.9 mm, 45 parts (7 on the bottom side), 57 nets.

Other parts of the board:
U$10: PCBFEAT-REV-056
U$12: NRF52840_BOT
U$14: NRF52840_TOP
