Phalkon-Industries/phoenix-instrument/platformio/PoenixV1-Firmware/python/phoenix_benchmark/cli.py

"""Command-line interface for Phoenix benchmark orchestration."""

from __future__ import annotations

import argparse
import datetime as _dt
import sys
import time
from pathlib import Path
from typing import Iterable, List

if (
    __package__ is None or __package__ == ""
):  # pragma: no cover - executed in script mode
    package_root = Path(__file__).resolve().parents[1]
    if str(package_root) not in sys.path:
        sys.path.insert(0, str(package_root))

import serial

from phoenix_benchmark.report import (
    DriftCaptureBurst,
    create_report,
    generate_drift_capture_artifacts,
    parse_drift_capture_transcript,
)
from phoenix_benchmark.schema import BenchmarkCommand, load_command_plan


def _build_parser() -> argparse.ArgumentParser:
    parser = argparse.ArgumentParser(
        prog="phoenix-benchmark",
        description=(
            "Execute Phoenix benchmark plans against connected hardware, capture the serial transcript, "
            "and generate an automated Markdown report with plots."
        ),
    )
    parser.add_argument(
        "plan", type=Path, help="Path to a JSON command plan to validate"
    )
    parser.add_argument(
        "--port",
        dest="port",
        default=None,
        help="Serial port that exposes the Phoenix benchmark firmware (for example, COM9 or /dev/ttyUSB0).",
    )
    parser.add_argument(
        "--dry-run",
        action="store_true",
        help="Parse and echo the command plan without contacting hardware.",
    )
    parser.add_argument(
        "--output",
        type=Path,
        default=None,
        help="Directory for generated reports. Defaults to ~/Downloads/phoenix-benchmark/<timestamp>.",
    )
    parser.add_argument(
        "--ready-timeout",
        type=float,
        default=DEFAULT_READY_TIMEOUT_SECONDS,
        help=(
            "Seconds to wait for the firmware '# ready' banner before aborting. "
            "Use 0 for an immediate failure if no data is received."
        ),
    )
    parser.add_argument(
        "--command-timeout",
        type=float,
        default=DEFAULT_COMMAND_TIMEOUT_SECONDS,
        help=(
            "Seconds to wait for benchmark output between serial lines before aborting. "
            "Applies separately to each command in the plan."
        ),
    )
    return parser


def _render_preview(commands: Iterable[BenchmarkCommand]) -> str:
    lines: List[str] = []
    for index, command in enumerate(commands, start=1):
        descriptor = command.to_serial_line().strip()
        lines.append(f"{index:02d}: {descriptor}")
    return "\n".join(lines)


def _materialise_dwell_series(command: BenchmarkCommand) -> List[int]:
    if command.name != "dwell_sweep":
        return []

    start = command.parameters.get("start_dwell_us")
    end = command.parameters.get("end_dwell_us")
    step = command.parameters.get("dwell_step_us")

    if (
        not isinstance(start, int)
        or not isinstance(end, int)
        or not isinstance(step, int)
    ):
        return []
    if step <= 0 or start > end:
        return []

    span = end - start
    if span == 0:
        return [start]

    increments = span // step
    series = [start + offset * step for offset in range(increments + 1)]
    if not series:
        series.append(start)
    return series


def _log_dwell_schedules(commands: Iterable[BenchmarkCommand]) -> None:
    for index, command in enumerate(commands, start=1):
        if command.name != "dwell_sweep":
            continue
        series = _materialise_dwell_series(command)
        if not series:
            sys.stdout.write(
                f"# dwell_sweep_schedule,index={index},steps=0,warning=empty_schedule\n"
            )
            continue
        joined = "|".join(str(value) for value in series)
        sys.stdout.write(
            f"# dwell_sweep_schedule,index={index},steps={len(series)},dwells={joined}\n"
        )


DEFAULT_READY_TIMEOUT_SECONDS = 30.0
DEFAULT_COMMAND_TIMEOUT_SECONDS = 180.0


def _emit_drift_capture_summary(bursts: List["DriftCaptureBurst"]) -> None:
    if not bursts:
        return

    warning_set = {label for burst in bursts for label in burst.warning_labels}
    warning_label = "|".join(sorted(warning_set)) if warning_set else "none"
    slug_label = "|".join(burst.slug() for burst in bursts)
    sys.stdout.write(
        "# drift_capture_summary,"  # Intentional prefix for grep-friendly output.
        f"bursts={len(bursts)},"
        f"slugs={slug_label},"
        f"warnings={warning_label}\n"
    )


def main(argv: Iterable[str] | None = None) -> int:
    parser = _build_parser()
    args = parser.parse_args(list(argv) if argv is not None else None)

    commands = load_command_plan(args.plan)
    preview = _render_preview(commands)

    sys.stdout.write("# phoenix benchmark command plan\n")
    sys.stdout.write(preview + "\n")
    _log_dwell_schedules(commands)

    if args.dry_run:
        return 0

    if args.port is None:
        parser.error("--port is required unless --dry-run is supplied")

    ready_timeout = max(0.0, float(args.ready_timeout))
    command_timeout = max(0.0, float(args.command_timeout))

    output_dir = _resolve_output_dir(args.output)
    transcript: List[str] = []
    total_steps = len(commands)

    try:
        with serial.Serial(args.port, 115200, timeout=1.0) as connection:
            _request_ready_prompt(connection)
            _await_ready_prompt(connection, transcript, ready_timeout)
            _execute_plan(
                connection,
                commands,
                transcript,
                command_timeout,
                total_steps,
            )
    except serial.SerialException as exc:  # pragma: no cover - sanity guard
        sys.stderr.write(f"# ERROR: {exc}\n")
        return 1
    except KeyboardInterrupt:  # pragma: no cover - user initiated
        sys.stderr.write("# aborted_by_user\n")
        return 130

    output_dir.mkdir(parents=True, exist_ok=True)
    drift_bursts = parse_drift_capture_transcript(transcript)
    generate_drift_capture_artifacts(drift_bursts, output_dir)
    _emit_drift_capture_summary(drift_bursts)

    artifacts = create_report(transcript, args.plan, output_dir, drift_bursts)
    recommendations = getattr(artifacts, "pot_sweep_recommendations", {}) or {}
    warning_label = getattr(artifacts, "pot_sweep_warning", None)
    if recommendations or warning_label:
        blue = recommendations.get("blue", "--")
        green = recommendations.get("green", "--")
        warning = recommendations.get("warning")
        if not warning:
            warning = warning_label if warning_label else "none"
        sys.stdout.write(
            f"# pot_sweep_summary,blue={blue},green={green},warnings={warning}\n"
        )
    dwell_recommendations = getattr(artifacts, "dwell_sweep_recommendations", {}) or {}
    dwell_warning = getattr(artifacts, "dwell_sweep_warning", None)
    if dwell_recommendations:
        recommended = dwell_recommendations.get("recommended")
        stable = dwell_recommendations.get("stable_dwells", [])
        threshold = dwell_recommendations.get("threshold")
        recommended_label = str(recommended) if recommended is not None else "--"
        stable_label = "|".join(str(value) for value in stable) if stable else "--"
        if isinstance(threshold, (int, float)):
            threshold_label = f"{float(threshold):.2f}"
        else:
            threshold_label = "--"
        warning = dwell_warning if dwell_warning else "none"
        sys.stdout.write(
            "# dwell_sweep_summary,"
            f"recommended={recommended_label},"
            f"stable={stable_label},"
            f"threshold={threshold_label},"
            f"warnings={warning}\n"
        )
    sys.stdout.write(f"# report_written,{artifacts.report_markdown_path}\n")

    return 0


def _await_ready_prompt(
    connection: serial.Serial, transcript: List[str], ready_timeout: float
) -> None:
    deadline = (
        time.monotonic() + ready_timeout if ready_timeout > 0 else time.monotonic()
    )
    while True:
        line = connection.readline()
        if not line:
            if ready_timeout == 0 or (
                ready_timeout > 0 and time.monotonic() > deadline
            ):
                raise serial.SerialException(
                    "Timed out waiting for ready prompt from device"
                )
            continue
        decoded = line.decode("utf-8", errors="replace").strip()
        sys.stdout.write(decoded + "\n")
        transcript.append(decoded)
        if decoded.endswith("ready"):
            break
    deadline = (
        time.monotonic() + ready_timeout if ready_timeout > 0 else time.monotonic()
    )


def _execute_plan(
    connection: serial.Serial,
    commands: Iterable[BenchmarkCommand],
    transcript: List[str],
    command_timeout: float,
    total_steps: int,
) -> None:
    if total_steps <= 0:
        return

    for index, command in enumerate(commands, start=1):
        _emit_progress(index, total_steps, command)
        payload = command.to_serial_line().encode("utf-8")
        connection.write(payload)
        connection.flush()
        _stream_until_complete(connection, transcript, command_timeout)


def _stream_until_complete(
    connection: serial.Serial, transcript: List[str], command_timeout: float
) -> None:
    deadline = (
        time.monotonic() + command_timeout if command_timeout > 0 else time.monotonic()
    )
    while True:
        line = connection.readline()
        if not line:
            if command_timeout == 0 or (
                command_timeout > 0 and time.monotonic() > deadline
            ):
                raise serial.SerialException(
                    "Timed out waiting for benchmark completion"
                )
            continue
        decoded = line.decode("utf-8", errors="replace").strip()
        sys.stdout.write(decoded + "\n")
        transcript.append(decoded)
        if decoded.startswith("# error"):
            raise serial.SerialException(f"Device reported error: {decoded}")
        if decoded.endswith("benchmark_complete"):
            break
    deadline = (
        time.monotonic() + command_timeout if command_timeout > 0 else time.monotonic()
    )


def _request_ready_prompt(connection: serial.Serial) -> None:
    # Send a blank line to prompt the firmware to re-emit its ready banner when
    # the host attaches after an earlier session.
    connection.write(b"\n")
    connection.flush()


def _emit_progress(step: int, total: int, command: BenchmarkCommand) -> None:
    timestamp = _dt.datetime.now(tz=_dt.timezone.utc).replace(microsecond=0)
    iso_timestamp = timestamp.strftime("%Y-%m-%dT%H:%M:%SZ")
    sys.stdout.write(
        f"# progress,step={step},total={total},command={command.name},started_at={iso_timestamp}\n"
    )
    sys.stdout.flush()


def _resolve_output_dir(requested: Path | None) -> Path:
    if requested is not None:
        return requested

    downloads = Path.home() / "Downloads"
    timestamp = _dt.datetime.now().strftime("%Y%m%d-%H%M%S")
    if downloads.exists():
        return downloads / "phoenix-benchmark" / timestamp
    return Path.cwd() / "phoenix-benchmark-reports" / timestamp


if __name__ == "__main__":
    raise SystemExit(main())
