Phalkon-Industries/phoenix-instrument/(commit log)

2025-06-27 worked on some schematic stuff, looked into lipo charging
    [phoenix-main-board-constant-current.kicad_pcb, phoenix-main-board-constant-current.kicad_sch]
2025-07-11 schematic pretty much done
    [Adafruit nRF52840 Bluefruit Feather Express Rev E.kicad_pcb, Adafruit nRF52840 Bluefruit Feather Express Rev E.kicad_sch, LED.FCStd, phoenix-main-board-constant-current.kicad_pcb, phoenix-main-board-constant-current.kicad_sch, phoenix-main-board.kicad_pcb, phoenix-main-board.kicad_sch]
2025-07-17 finish majority of pcb design
    [Cuvette.FCStd, LED.FCStd, phoenix-main-board.kicad_pcb, phoenix-main-board.kicad_sch]
2025-07-23 v1.0.0 release
    [Cuvette.FCStd, phoenix-assembly.FCStd, phoenix-main-board.kicad_pcb, phoenix-main-board.kicad_sch]
2025-09-09 Work on pick n place files
    [bom.csv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]
2025-09-26 Add board pinout header file
2025-09-26 Update led_test example with fade and chnage name to example
2025-09-26 FW: Test additional LEDs in example
2025-09-28 PCB: Fix OPA2380 pinout
    [phoenix-main-board.kicad_pcb, phoenix-main-board.kicad_sch]
2025-09-28 FW: Try to get ADC working
2025-09-29 FW: Basic Working ADC Example
2025-09-30 FW: Fix up tests implementing untested things
    [test_mcp356x.cpp]
2025-10-02 FW: Get main to compile without errors
    [main.cpp]
2025-10-02 FW: Set up test framework for AD524x
2025-10-02 FW: Implement ad524x I2C basics
2025-10-02 PCB: Update changelog (forgot to before)
2025-10-03 FW: Implement an LED library
2025-10-07 FW: Refactor using new led_router library
2025-10-07 FW: Implement ADC HAL Layer
2025-10-07 PCB: Fix LM7705 SD wrong polarity
    [phoenix-main-board.kicad_pcb, phoenix-main-board.kicad_sch]
2025-10-12 fix(cli): abort when firmware reports benchmark error
    [cli.py]
2025-10-12 refactor(channel-map): adopt phoenix_benchmark_ API and relocate deps
    - rename channel_map headers/types to phoenix_benchmark_* C-style and keep legacy shims forwarding to the new names
    - move formatter, support, and command parser into channel_map/ alongside the scenario API
    - update Unity suites and the example sketch to use the new includes/types and confirm on-device tests still pass
    Tests: pio test -e main -vv -f test_command_parser; pio test -e main -vv -f test_channel_map
2025-10-16 feat(adc_hal): Implement in interupt driven adc read
2025-10-17 fix(pot_sweep): update parameters of pot_sweep
    [phoenix_benchmark.cpp, test_phoenix_benchmark_support.cpp]
2025-10-17 fix(benchmark): fix osr setting not changed back after osr_sweep
    [test_phoenix_benchmark_support.cpp]
2025-10-21 fix(dwell_seep): add in comments
    [phoenix_benchmark.cpp]
2025-10-21 feat(on_drift): Implement led on drift benchmark
    [phoenix_benchmark.cpp, test_phoenix_benchmark_support.cpp]
2025-10-21 feat(drift_capture): implement python tooling for drift capture
    [cli.py, report.py, schema.py]
2025-10-21 feat(drift_capture): update report format
    [report.py, schema.py]
2025-11-03 refactor(device_settings): create device settings header to store hw settings for reuse in lib
2025-11-03 refactor(device_setup): restructure to fix build issues
    [device_setup.cpp, device_setup.hpp, main.cpp]
2025-11-03 fix(light_reading): move sweep array to global static variable
    [test_light_readings.cpp]
2025-11-03 refactor(power-control): factor out power control functions and refactor code
2025-11-03 refactor(channel_map): move hardware stuff to device setup
2025-11-03 fix(device_settings): attempt fix on confusion between led number and led color
    [device_setup.cpp]
2025-11-04 refator(ph_equations): Switch over to use of phoenix guards
2025-11-07 fix(cold-sweep): update report layout for cold-sweep
    [report.py]
2025-11-07 feat(phoenix-ble): set up test framework
2025-11-09 feat(ble-device-test): implement a basic pytest for ble device testing
2025-11-09 docs(mock-app): update doc on python testing device, and on other ble stuff
2025-11-09 refactor(benchmarks): update all references to led1 and 2 to the respective blue and green leds
2025-11-09 tests(benchmark): fix up the pytest directory and add documentation on desired commands for running tests
    [report.py]
2025-11-09 feat(drift-capture): use default wiper codes from light reader config
    [phoenix_benchmark.cpp, test_phoenix_benchmark_support.cpp]
2025-11-09 fix(benchmark): Add all drain values to all plots. and all lines have their own y axis
    [report.py]
2025-11-13 PCB: Update to V1.0.1. Begin preparation for production
    [phoenix-main-board.kicad_pcb, phoenix-main-board.kicad_sch]
2025-11-13 feat(nrf_pwm_example): create example using nrf pwm setup
2025-11-13 feat(pwm_example): implement both LEDs at 50% duty cycle in example
2025-11-13 feat(pwm-example): get full pwm sequence working
2025-11-14 feat(pwm_driver): add pwm driver in led_router lib
2025-11-14 feat(example): Add new example for driver code pwm, and split nrf to separate example
2025-11-14 fix(pwm_driver): fix pwm waveform and driver example code
    [device_setup.cpp, device_setup.hpp, led_router_pwm_driver_example.cpp, led_router_pwm_nrf_example.cpp, test_led_router.cpp]
2025-11-14 fix(pwm_driver): update comments and update names
    [led_router_pwm_driver_example.cpp, test_led_router.cpp]
2025-11-14 fix(pwm_driver): Swap In1 and In2 for stable light output (hardware issue)
    [device_setup.cpp, led_router_pwm_nrf_example.cpp]
2025-11-15 feat(osr_latency): Add in hardware implementation for measurement on adc and its timings
2025-11-18 docs(mcu): add nrf52840 datasheet to pcb datasheets directory
2025-11-18 docs(pwm): update docs to include brief explanation of pwm methods
2025-11-18 feat(pwm-interrupt-example): add example testing gpio interrupt with pwm running
2025-11-18 fix(led_colors): correct the blue/grenn led2/led1 throughout to actually be correct
    [device_setup.cpp, device_setup.hpp, photodiode_sweep.cpp, test_led_router.cpp, test_phoenix_benchmark_support.cpp]
2025-11-18 feat(pwm-reads): Implement pwm driven adc reads
2025-11-18 feat(SPI): Set spi to 20MHz for faster comms speeds
2025-11-18 refactor(mcp356x): switch to microsecond timeout for better resolution
2025-11-18 feat(pwm_sweep_example): implement a sweep example that uses the pwm drivers for testing and debugging
2025-11-18 feat(device_setup): include mcp356x setting in device_setup
2025-11-19 fix(main): update a depracted header name and update default device settings
    [device_setup.cpp, main.cpp]
2025-11-19 feat(adc_hal): switch from interrupts to just waiting for change on IRQ pin via rapid polling
2025-11-19 feat(pwm_reads): remove interrupt based led edge detection, and move to state machine polling method of pwm alignment
2025-11-21 PCB: add resistors to LED path for stability
    [phoenix-pcb-v1.0.1-tsunami.FCStd]
2025-11-21 feat(thermistor_reader): implement thermistor reader library
2025-11-21 feat(thermistors): add sketch example for thermistor_read
2025-11-24 PCB: Complete V1.0.1 Tsunami
    [phoenix-main-board.kicad_pcb, phoenix-main-board.kicad_sch]
2025-12-05 CAD: Complete LED Shroud initial design
    [Cuvette.FCStd, LED.FCStd, Photodiode.FCStd, phoenix-assembly.FCStd, phoenix-pcb-v1.0.1-tsunami.FCStd, shroud-test.3mf]
2025-12-11 CAD: Complete first enclosure design
    [ecnlosure-back.3mf, ecnlosure-cap.3mf, ecnlosure-front.3mf, phoenix-assembly.FCStd, prusaslicer-enclosure.3mf]
2025-12-11 Fix(5v): Fix 5V instability (hopefully) and add engative bias pin
    [device_setup.cpp, device_setup.hpp, led_example.cpp, led_router_pwm_driver_example.cpp, photodiode_sweep.cpp, test_light_readings.cpp, test_power_control.cpp]
2025-12-11 fix(drift_capture): Fix drift capture reading the correct led, and update mcp365x tests
    [device_setup.cpp, phoenix_benchmark.cpp, test_mcp356x_latency_lookup.cpp, test_phoenix_benchmark_support.cpp]
2025-12-15 fix(settings): adjust gain settings for new encosure design
    [device_setup.cpp]
2025-12-15 feat(cli): implement cli framework
2025-12-15 fix(tests): include device setup so that the tests get tinyusb library
    [test_ad524x.cpp, test_adc_hal.cpp, test_led_router.cpp, test_mcp356x.cpp, test_phoenix_benchmark_support.cpp]
2026-01-16 feat(settings): Add device settings file and handlers for storing settings in flash
2026-01-16 fix(settings): update location of default settings values to be in device_settings.hpp
    [device_setup.cpp, device_setup.hpp, test_phoenix_settings.cpp]
2026-01-16 feat(cli): Send banner on every serial connection, and start leds on power up
2026-01-16 fix(settings): fix wiper codes being applied to wrong channel
    [test_phoenix_settings.cpp]
2026-01-18 fix(tests): Update some tests
    [test_ad524x.cpp, test_light_calibration.cpp, test_phoenix_settings.cpp]
2026-03-20 fix(misc): couple final things
    [device_setup.cpp]
2026-03-20 CAD: complete enclosure design for tsunami boards
    [lee-filter-holder-for-cuvette-BodyPocket002.step, lee-filter-holder-for-cuvette.FCStd, prusaslicer-enclosure.3mf]
2026-03-20 PCB: Complete V1.1.0-Tornado
    [phoenix-main-board.kicad_pcb, phoenix-main-board.kicad_sch]
2026-07-31 switch to blackmagic probe
2026-07-31 update power domain
2026-07-31 update thermistor and adc code and tests for tornado board
2026-07-31 complete mcp41u driver
2026-07-31 fix phoenix_settings to work with digipot_hal
    [test_phoenix_settings.cpp]
2026-07-31 Get thermistors actually kind of working
2026-07-31 get stubbed thermistor tests working
2026-08-01 get light_readings tests working Had an issue where some tests were dropping the 5V power which was corrupting the I2C bus config on the board chips. Just deleted those tests since they were testing 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
    [test_light_readings.cpp]
2026-08-01 add some thermistor documentation
2026-08-02 Fix light_calibration and ensure support for all digipot values up to 16bits
    [device_setup.hpp, photodiode_sweep.cpp, test_light_calibration.cpp]
2026-08-02 Fix phoenix settings tests
    [test_phoenix_benchmark_support.cpp]
2026-08-04 Get light readings working correcly. Issue was wrong channel selected on the green wiper digipot
    [device_setup.cpp, device_setup.hpp, photodiode_sweep.cpp]
2026-08-04 fix: light calibration error on main application
    [test_light_calibration.cpp]
2026-10-06 PCB: Small updates
    [bom.csv, phoenix-assembly.FCStd, phoenix-main-board-BOM.csv, phoenix-main-board.csv, phoenix-main-board.kicad_pcb]
